poisnoir/Capstone/contract/icd/README.md

# Interface control documents (ICDs)

An ICD freezes one interface: the physical layer, the information that crosses,
the rates/limits, the failsafe behaviour, and what is left to the implementers.
Each ICD names an owner on each side.

| ICD | Interface | Status | Owners |
|---|---|---|---|
| `pico_link.md` | BRD-01 (FPGA) ↔ Pico 2 follower | **Rev A, frozen 2026-10-28** | FPGA engineer / follower firmware |
| `adc_fpga.md` | AD7768-4 ↔ FPGA capture | Stub — see SC-05/SC-05a–c, SC-07 | Tung / William |
| `dac_fpga.md` | DAC80508 ↔ FPGA DDS/SPI | Stub — see decision #19, SC-07 | Tung / Kevin |
| `power.md` | Power entry, E-stop, rails, grounding | Stub — see decision #7/#10/#20 | Tung |
| `mechanical.md` | FG/pen/enclosure/arm mounts, 150 mm rule | Stub — see SC-01c, SC-04b, D2 | Tung / Tristan |

**A stub is not a frozen interface.** Until an ICD is marked frozen, the
`system_contract.md` rows and the decisions log are the contract. Do not build a
new interface against a stub without a written deviation.

The `pico_link/vectors/` folder holds shared conformance vectors once the Pico
side chooses a frame encoding (ICD §5 leaves encoding, field widths and CRC to
the implementers).
