poisnoir/Capstone/docs/extracts/README.md

# Thesis extracts (local-only working set)

- `Jaeger2018_filament-sensor-model_Ch3_extract.txt` — Ch.3 model/solver
- `Jaeger2018_bespoke-sensor_Ch7_extract.txt` — Ch.7 coil design
- `Jaeger2018_filament-sensor-model_extract.pdf` — 27-page crop

All three are **not in the repository** (thesis copyright). Generate them
locally from the full thesis:

```bash
# default: ./HAJ_Thesis_2018.pdf; override with THESIS=/path/to/thesis.pdf
./tools/extract_jaeger.sh
```

The full thesis is not in the repo; see `../reference/MANIFEST.md` REF-01.
