poisnoir/Capstone/docs/handoff/README.md

# Handoff documents

Working handoffs between subsystems. These are design records, not the
contract; if a handoff and `contract/` disagree, the contract wins.

| Document | What it covers |
|---|---|
| `m16-fpga-handoff.md` | M16 DAC/filter decision, FPGA interface, pinout, clocking |
| `solver-algorithm-handoff.md` | LM/TRF solver port, cost function, retry strategy |
| `system-flowchart-handoff.md` | System flow, stage boundaries, schedule |
| `EM-AccuBot-system.svg` | System block diagram |
| `EM-AccuBot-fpga-pipeline.svg` | FPGA pipeline diagram |
| `m16-section-diagram.png` / `.svg` | M16 section diagram |

The Phase 2 design record is in `../phase2/`.
