poisnoir/Capstone/hardware/brd-01/frontend/README.md

# hardware/brd-01/frontend — receiver amp + pen coil (reference)

Upstream (pristine, do not edit): `vendor/anser-osf/Design Files/Sensor Amplifier/`
- `CAD/Sensor Amplifier PCB (Eagle).zip` — `E301 2.0/3.0 .brd/.sch` (Eagle)
- `CAD/Gerbers/Sensor Amplifier PCB Gerbers.rar`

Pen sensor itself: hand-wound per thesis Ch.7 (see `docs/extracts/`, Table 7.1 coils A–E,
ferrite 3C90 12×6mm µr≈2300 for +10dB). New pen mechanics + preamp/ADC interface live here.
