poisnoir/Capstone/docs/reference/anser-osf-provenance.md

# PROVENANCE — vendor/anser-osf (pristine upstream snapshot, do not edit)

- Source: OSF project **Anser EMT** (node `47q8q`), "An open electromagnetic tracking system platform"
- API: `https://api.osf.io/v2/nodes/47q8q/` — downloaded 2026-10-13 via
  `api.osf.io/v2/nodes/47q8q/files/osfstorage/<id>/` listing + `osf.io/download/<guid>/?direct`
- Upstream: `https://osf.io/47q8q/` (project), code pointer in `P&O Code/Matlab/Latest Code.txt`:
  `https://github.com/BioDesignUCC/AnserEMT` (check — siblings: `AlexJaeger/AnserEMT`,
  `AlexJaeger/python-anser`, `StephenHinds/qt-anser`, `AnserEMT/Homepage-Anser`)
- Snapshot: 35 files, ~43MB, `DONE files=35 fails=[]`
- Top level: `Design Files/` (FG board, emitter coil, sensor amp, AC driver),
  `P&O Code/Matlab/` (`MatlabCode.zip` + `Latest Code.txt`), `System Manual/` (`Manual.pdf`, 23pp, 2017)
- License holders (OSF metadata): Alexander Jaeger, Kilian O Donoghue (2017)
- Rule: never edit files here. Port/reference into `software/`, `hardware/`, `docs/`;
  record the mapping in each destination README.
