poisnoir/Capstone/docs/reference/MANIFEST.md

# Reference manifest

These files are **not in the repository** (copyright, size, or both). Each row says what it is, which docs use it, and how to obtain it. `manifest.yml` is the source of truth; this page is generated by `python3 tools/gen_reference_manifest.py`.

`python3 tools/check_references.py` verifies that every external file referenced in a doc has a row here. The repo is public; run the **public-repo checklist** at the bottom before a release.

Manifest version: 1 · updated 2026-10-29

| ID | File | Size | Needed for | How to obtain | Publish? |
|---|---|---|---|---|---|
| REF-01 | `HAJ_Thesis_2018.pdf` | 116 MB | AGENTS.md reference model; contract/system_contract.md SC-01…SC-04; docs/phase2/README.md and the design record | UCC CORA repository / author; a local copy is already on a team machine | no |
| REF-02 | `AnserEMT-onlineversion.pdf` | 2.1 MB | docs/phase2/README.md baseline (1.14 mm / 0.04°); docs/phase2/anser-baseline-findings.md | Publisher / IEEE; cite the paper, do not redistribute | link-only |
| REF-03 | `Catheter Position Tracking System Using Planar Magnetics and Closed Loop Current Control - Kilian ODonoghue et al.pdf` | 1.8 MB | AGENTS.md closed-loop current-driver rule; docs/phase2/pen_link_budget.md | Publisher / IEEE; cite the paper, do not redistribute | link-only |
| REF-04 | `Capstone_Manual_2026.pdf` | 456 KB | docs/phase2/README.md Phase 2 deliverables; docs/phase2/design_order.md | Concordia course Moodle | no |
| REF-05 | `12477_Cavaliere.pdf` | 21 MB | background reading only | Local copy / library; provenance to be confirmed | no |
| REF-06 | `vendor/anser-osf/` | 43 MB | hardware/fg-01/, hardware/brd-01/driver/, hardware/brd-01/frontend/; software/anser-matlab-ref/ (unpacked MATLAB golden model); docs/reference/anser-osf-provenance.md | OSF node 47q8q; download the snapshot, keep it pristine — https://osf.io/47q8q/ | no |
| REF-07 | `docs/ad7768-ad7768-4.pdf` | 4.0 MB | contract/system_contract.md SC-05; docs/phase2/adc_justification.md; docs/phase2/adc_interface_closure.md | Analog Devices product page (AD7768-4), datasheet Rev.D — https://www.analog.com/en/products/ad7768-4.html | link-only |
| REF-08 | `reference-cache/datasheets/` | 16 MB | hardware/brd-01/ part selection and layout; docs/phase2/driver_power_requirements.md | Each manufacturer by part number: AD7768-4, ADS1274, DAC80508, LTC1563-2, LMH6321, INA163, ADA4940-2, ADR434, ME60A1503F01, RV-1515D, TPS7A4701/TPS7A33/TPS7A20, XC7A35T/XC7A50T, Citizen CSX750FBC32.768M; Neutrik/Mogami connectors and cable | no |
| REF-09 | `docs/extracts/Jaeger2018_filament-sensor-model_extract.pdf` | 4.2 MB | agent working set; Ch.3 model/solver and Ch.7 coil design | Generated from REF-01; do not redistribute the crop | no |
| REF-10 | `docs/Materials procurement.pdf` | 1.2 MB | procurement/BOM practice reference | Concordia course Moodle | no |
| REF-11 | `docs/phase1/Phase 1 Report - Team 25 (ELEC-COEN 490).docx` | 228 KB | Phase 1 specs #1–25 and the frozen baseline; docs/phase2/README.md | Team file; local-only, not in the repo (contains student IDs) | no |
| REF-12 | `docs/extracts/Jaeger2018_filament-sensor-model_Ch3_extract.txt` | 22 KB | AGENTS.md reference model; fpga/ solver port | Generated from REF-01; local-only, not in the repo (thesis copyright) | no |
| REF-13 | `docs/extracts/Jaeger2018_bespoke-sensor_Ch7_extract.txt` | 33 KB | AGENTS.md coil design (Table 7.1); hardware/pen/ | Generated from REF-01; local-only, not in the repo (thesis copyright) | no |

## Acquisition details

### REF-01 — Jaeger, electromagnetic tracking thesis (UCC, 2018), 282 pp

- **File:** `HAJ_Thesis_2018.pdf`
- **Size:** 116 MB
- **Needed for:** AGENTS.md reference model; contract/system_contract.md SC-01…SC-04; docs/phase2/README.md and the design record
- **How to obtain:** UCC CORA repository / author; a local copy is already on a team machine
- **Local path:** `<local>/CAPSTONE/HAJ_Thesis_2018.pdf`
- **Publish:** False
- **SHA-256:** `eebd2824176a1af256fd1e3361289dd8a110bd29eb318e36d1d4a2b843809e8e`
- **Regenerate:** docs/extracts/*.txt and the PDF crop via tools/extract_jaeger.sh

### REF-02 — Jaeger et al., Anser EMT (IEEE TBME, 2017)

- **File:** `AnserEMT-onlineversion.pdf`
- **Size:** 2.1 MB
- **Needed for:** docs/phase2/README.md baseline (1.14 mm / 0.04°); docs/phase2/anser-baseline-findings.md
- **How to obtain:** Publisher / IEEE; cite the paper, do not redistribute
- **Local path:** `<local>/CAPSTONE/AnserEMT-onlineversion.pdf`
- **Publish:** link-only
- **SHA-256:** `2fa9926ae2758b5af40cd16a801190821a01eb35834f7e8dced8747d6a1dc520`

### REF-03 — O'Donoghue et al., catheter tracking with planar magnetics (2014)

- **File:** `Catheter Position Tracking System Using Planar Magnetics and Closed Loop Current Control - Kilian ODonoghue et al.pdf`
- **Size:** 1.8 MB
- **Needed for:** AGENTS.md closed-loop current-driver rule; docs/phase2/pen_link_budget.md
- **How to obtain:** Publisher / IEEE; cite the paper, do not redistribute
- **Local path:** `<local>/CAPSTONE/Catheter Position Tracking System Using Planar Magnetics and Closed Loop Current Control - Kilian ODonoghue et al.pdf`
- **Publish:** link-only
- **SHA-256:** `b05e3d82fdae04b52dcc2541691f10af3c3b059ac2838022524bbab8bc087af9`

### REF-04 — Concordia ELEC/COEN 490 Capstone manual 2026

- **File:** `Capstone_Manual_2026.pdf`
- **Size:** 456 KB
- **Needed for:** docs/phase2/README.md Phase 2 deliverables; docs/phase2/design_order.md
- **How to obtain:** Concordia course Moodle
- **Local path:** `<local>/CAPSTONE/Capstone_Manual_2026.pdf`
- **Publish:** False
- **SHA-256:** `2ba7b441a31877a31d0e0416103b7bb66e8ac4697107b7dc5aa56b17397c06c4`

### REF-05 — Cavaliere reference document (local copy)

- **File:** `12477_Cavaliere.pdf`
- **Size:** 21 MB
- **Needed for:** background reading only
- **How to obtain:** Local copy / library; provenance to be confirmed
- **Local path:** `<local>/CAPSTONE/12477_Cavaliere.pdf`
- **Publish:** False
- **SHA-256:** `d337f4ebb04611408f6ec238b79f92c7a3a17e8bb0f1ea0ec5198b81c8ab988c`

### REF-06 — Anser OSF snapshot (node 47q8q, 35 files, 2026-10-13)

- **File:** `vendor/anser-osf/`
- **Size:** 43 MB
- **Needed for:** hardware/fg-01/, hardware/brd-01/driver/, hardware/brd-01/frontend/; software/anser-matlab-ref/ (unpacked MATLAB golden model); docs/reference/anser-osf-provenance.md
- **How to obtain:** OSF node 47q8q; download the snapshot, keep it pristine
- **URL:** https://osf.io/47q8q/
- **Local path:** `<local>/CAPSTONE/vendor/anser-osf/`
- **Publish:** False
- **SHA-256:** `3b4446554229825f57d2f7e8fcf72e74ba61e0ca850b7e627f75c092b071d9ad`
- **Regenerate:** see docs/reference/anser-osf-provenance.md

### REF-07 — Analog Devices AD7768 / AD7768-4 datasheet Rev.D

- **File:** `docs/ad7768-ad7768-4.pdf`
- **Size:** 4.0 MB
- **Needed for:** contract/system_contract.md SC-05; docs/phase2/adc_justification.md; docs/phase2/adc_interface_closure.md
- **How to obtain:** Analog Devices product page (AD7768-4), datasheet Rev.D
- **URL:** https://www.analog.com/en/products/ad7768-4.html
- **Local path:** `<local>/CAPSTONE/docs/ad7768-ad7768-4.pdf`
- **Publish:** link-only
- **SHA-256:** `bbb52b34c5a251b9dc01719357f3f80a1d4c2b274f2136704c80500cdd7d3e27`

### REF-08 — Manufacturer datasheets (ADC, DAC, driver, connectors, cable)

- **File:** `reference-cache/datasheets/`
- **Size:** 16 MB
- **Needed for:** hardware/brd-01/ part selection and layout; docs/phase2/driver_power_requirements.md
- **How to obtain:** Each manufacturer by part number: AD7768-4, ADS1274, DAC80508, LTC1563-2, LMH6321, INA163, ADA4940-2, ADR434, ME60A1503F01, RV-1515D, TPS7A4701/TPS7A33/TPS7A20, XC7A35T/XC7A50T, Citizen CSX750FBC32.768M; Neutrik/Mogami connectors and cable
- **Local path:** `<local>/CAPSTONE/reference-cache/datasheets/`
- **Publish:** False
- **SHA-256:** `08782fd1accd4bfe586a5f1e83a547d940913ad303f28500998afbc5d8fd60a4`
- **Regenerate:** download from each vendor; keep the filename

### REF-09 — Jaeger thesis extract, PDF pp.84–94 + 199–214 (27 pp)

- **File:** `docs/extracts/Jaeger2018_filament-sensor-model_extract.pdf`
- **Size:** 4.2 MB
- **Needed for:** agent working set; Ch.3 model/solver and Ch.7 coil design
- **How to obtain:** Generated from REF-01; do not redistribute the crop
- **Local path:** `<local>/CAPSTONE/docs/extracts/Jaeger2018_filament-sensor-model_extract.pdf`
- **Publish:** False
- **SHA-256:** `547966dbd079fe2e303aecc25bc1da23aa163418bebcd1f899888321a433d0c1`
- **Regenerate:** tools/extract_jaeger.sh (needs REF-01)

### REF-10 — COEN/ELEC 390 materials-procurement lecture (course material)

- **File:** `docs/Materials procurement.pdf`
- **Size:** 1.2 MB
- **Needed for:** procurement/BOM practice reference
- **How to obtain:** Concordia course Moodle
- **Local path:** `<local>/CAPSTONE/docs/Materials procurement.pdf`
- **Publish:** False
- **SHA-256:** `d3b91997360d8b05a39356cbaf6ce3da1eee69a4009f7a31863e243db2628726`

### REF-11 — Team 25 Phase 1 report (contains student IDs)

- **File:** `docs/phase1/Phase 1 Report - Team 25 (ELEC-COEN 490).docx`
- **Size:** 228 KB
- **Needed for:** Phase 1 specs #1–25 and the frozen baseline; docs/phase2/README.md
- **How to obtain:** Team file; local-only, not in the repo (contains student IDs)
- **Local path:** `<local>/CAPSTONE/docs/phase1/Phase 1 Report - Team 25 (ELEC-COEN 490).docx`
- **Publish:** False
- **SHA-256:** `24367e96278e5915f5d284fd3ab2a7793fe1be6be71fdba9ea64e68475d7142e`

### REF-12 — Jaeger Ch.3 text extract (local-only)

- **File:** `docs/extracts/Jaeger2018_filament-sensor-model_Ch3_extract.txt`
- **Size:** 22 KB
- **Needed for:** AGENTS.md reference model; fpga/ solver port
- **How to obtain:** Generated from REF-01; local-only, not in the repo (thesis copyright)
- **Local path:** `<local>/CAPSTONE/docs/extracts/Jaeger2018_filament-sensor-model_Ch3_extract.txt`
- **Publish:** False
- **SHA-256:** `generated; see tools/extract_jaeger.sh`
- **Regenerate:** tools/extract_jaeger.sh (needs REF-01)

### REF-13 — Jaeger Ch.7 text extract (local-only)

- **File:** `docs/extracts/Jaeger2018_bespoke-sensor_Ch7_extract.txt`
- **Size:** 33 KB
- **Needed for:** AGENTS.md coil design (Table 7.1); hardware/pen/
- **How to obtain:** Generated from REF-01; local-only, not in the repo (thesis copyright)
- **Local path:** `<local>/CAPSTONE/docs/extracts/Jaeger2018_bespoke-sensor_Ch7_extract.txt`
- **Publish:** False
- **SHA-256:** `generated; see tools/extract_jaeger.sh`
- **Regenerate:** tools/extract_jaeger.sh (needs REF-01)

## Regenerating the thesis extracts

The `.txt` extracts and the 27-page PDF crop are local-only (not tracked). Both are generated from REF-01:

```bash
# default: ./HAJ_Thesis_2018.pdf; override with THESIS=/path/to/thesis.pdf
./tools/extract_jaeger.sh
```

## Public-repo checklist

- [ ] Confirm the Phase 1 report is not tracked: `git ls-files | grep -i 'Phase 1 Report'` is empty.
- [ ] Confirm the thesis `.txt` extracts are not tracked.
- [ ] Confirm no tracked PDFs: `git ls-files | grep -i '\.pdf$'` is empty.
- [ ] Run `python3 tools/check_publish.py --public`.
- [ ] Run `python3 tools/check_references.py` and `python3 tools/check_doc_paths.py`.
- [ ] Flip visibility, then enable the branch ruleset (PR, 1 approval, code owners, status checks).
