poisnoir/Capstone/docs/phase1/README.md

# Phase 1 report (local-only)

`Phase 1 Report - Team 25 (ELEC-COEN 490).docx` — the frozen Phase 1 baseline
(specs #1–25, success criteria, schedule, budget).

**This file is not in the repository** because it contains student IDs. Ask a
team member for a copy (team drive / local machine). `tools/check_publish.py
--public` fails if it is ever tracked.

The Phase 2 design record is in `../phase2/`; the shared contract is in
`../../contract/`.
