poisnoir/Capstone/docs/reference/README.md

# Reference manifest

Third-party PDFs, datasheets and the vendor snapshot are **not committed**.
`manifest.yml` is the source of truth; `MANIFEST.md` is generated from it.

- `manifest.yml` — one entry per external file: ID, size, which docs use it, how
  to obtain it, publish permission, SHA-256, regeneration command.
- `MANIFEST.md` — the human-readable table and acquisition details. Generated by
  `python3 tools/gen_reference_manifest.py`.
- `anser-osf-provenance.md` — the tracked provenance summary for the OSF
  snapshot (`vendor/` is local-only).

## Add a reference

1. Add an entry to `manifest.yml` with an acquisition method (URL/DOI/OSF node/
   course Moodle/author) and a local path.
2. Run `python3 tools/gen_reference_manifest.py`.
3. Run `python3 tools/check_references.py`.

If a doc references a third-party file without a manifest row, the checker
fails. That is intentional: a reference nobody can obtain is not a reference.

## Current local-only locations

| Path | What |
|---|---|
| `vendor/anser-osf/` | OSF node `47q8q` snapshot (43 MB) |
| `reference-cache/datasheets/` | manufacturer datasheets (16 MB) |
| root `HAJ_Thesis_2018.pdf` | Jaeger thesis (116 MB) |
| root `AnserEMT-onlineversion.pdf`, `Catheter...pdf` | papers |
| root `Capstone_Manual_2026.pdf`, `12477_Cavaliere.pdf` | course/reference |
| `docs/ad7768-ad7768-4.pdf` | ADI datasheet |
| `docs/extracts/*.pdf` | thesis crop (regenerate with `tools/extract_jaeger.sh`) |
| `docs/extracts/*.txt` | thesis text extracts (local-only, copyright) |
| `docs/phase1/Phase 1 Report - Team 25 (ELEC-COEN 490).docx` | Phase 1 report (student IDs; local-only) |
| `docs/Materials procurement.pdf` | course lecture |
| `simulations/**/*.raw` | LTspice output (regenerate from `.cir`) |

The `.txt` thesis extracts and the Phase 1 report are **not tracked**. They are
kept on team machines only; `python3 tools/check_publish.py --public` fails if
either is ever added to git.
