poisnoir/Capstone/hardware/bom/BOM_ADC-01.xlsx

Sheet: README_AGENTS
BOM WORKING RULES — ADC-01 (Team 25, EM AccuBot). Shared format/process rules: see BOM_PEN-ANA-01.xlsx > README_AGENTS (same lecture: docs/Materials procurement.pdf + docs/BOM_template.xls). This file = sub-assembly ADC-01 ONLY (signal-path ADC + Vref). RQ: phase2/adc_justification.md RQ-A1..A7 + §9c-§9e.
LOCKED: AD7768-4 (RL7 if qty-1 price confirms, else RL) primary per §9e gate (simultaneous 4-ch, 256kSPS, D=133µs, lanes OK, DigiKey stock). BACKUP (QTY=0, do not order): ADS1274IPAPR (144kSPS, N≤500 frames). Vref ADR434BRZ 4.096V (CN-0540-class pairing).
OPEN ITEMS before order: (1) re-quote RL7 vs RL qty-1 in cart; (2) ADI lifecycle check (Mouser delist note); (3) ADC input network (precharge buffer/RC) settled — datasheet now in docs/; the 73pF coil budget is cable+conn+preamp input, not ADC Cin (see tone_plan.md); (4) MCLK coherency/jitter from TCXO/PLL plan (tone_plan integer-J; 1ns=73.4dB at 34kHz); (5) decoupling values at schematic (not listed here). Sign header before issue.

Sheet: BOM_ADC-01
Company: | Concordia University, Department of Electrical and Computer Engineering
Project: | EM AccuBot — Team 25 (ELEC/COEN 490)
Design ref.: | ADC-01 — Signal-path ADC + Vref (4-ch simultaneous SD + 4.096V ref)
Prepared by: | _Your name_ (replace placeholder before issue)
Rev.# | 0.01 | Date: | 2026-10-16 | (YYYY-MM-DD)
Approved by: | (sign before order)
Item # | Design Reference # | Description | Value | QTY | Unit | Manufacturer | Manufacturer Part# | Package | Type | Supplier | Supplier P/N | Price (CAD) | Ext.price (CAD)
1 | U1 | 24-bit 4-ch simultaneous sigma-delta ADC, 256kSPS/ch, FIR D=34/ODR≈133µs, SPI lanes (DCLK≥8.2M), 108dB DR; signal path Ch0=current pseudo-diff, Ch1=pen, Ch2=ref (LOCKED §9e) | AD7768-4BSTZ-RL7 (RL if cheaper @qty1) | 2 | pcs | Analog Devices | AD7768-4BSTZ-RL7 | 64-LQFP | IC-ADC | Digi-Key | AD7768-4BSTZ-RL7-ND? verify RL7-vs-RL qty-1 price in cart | 49.65
2 | U1-ALT (DO NOT ORDER) | 24-bit 4-ch simultaneous SD ADC, to 144kSPS; BACKUP ONLY (N≤500 frames; HTQFP PowerPAD needs hot-air/JLC) | ADS1274IPAPR | 0 | pcs | Texas Instruments | ADS1274IPAPR | HTQFP-64 PowerPAD | IC-ADC | Digi-Key | verify -ND at promotion time | TBD (backup)
3 | U2 | Series Vref 4.096V XFET 0.04% (CN-0540-class pairing for AD7768 REF); ADR4540 lower-noise alt documented not ordered | ADR434BRZ | 1 | pcs | Analog Devices | ADR434BRZ | 8-SOIC | IC-VREF | Digi-Key | ADR434BRZ-ND? verify in cart | 23.01
TOTAL this sub-assembly (CAD) — Rev 0.01 (re-quote RL7/RL + verify P/Ns at order)
NOTES: MCLK from TCXO/PLL (no part; FPGA clock plan). Cin + droop-temp + lifecycle checks per §9e before order. Decoupling values at schematic Rev (not listed).

Sheet: Sourcing_notes
Purpose | Pointers + order-time facts for ADC-01. RQ lives in phase2/adc_justification.md (RQ-A1..A7, §9c-§9e); do not duplicate math here.
U1 trace | §9e gate: simultaneous ✓ (4-ch), 256k≥250k preferred ✓ (at the line), D=133µs<0.5ms ✓, BW 110.8k ✓, 108dB ✓, lanes ✓. Chan map: Ch0 driver-current pseudo-diff, Ch1 pen true-diff, Ch2 ref, Ch3 spare. N=500→1.95ms / N=1000→3.9ms acq.
U1 order facts | DigiKey RL p.6056981 qty1 $34.84 USD=$49.65 CAD (x1.425), stock 4 (thin). RL7 p.6056982 also in-stock — compare qty-1 unit price in cart, take cheaper; fallback RL. Mouser 925 but delist-on-depletion note → run ADI lifecycle check pre-order.
U1-ALT facts | ADS1274IPAPR: TI quad 24b SD to 144kSPS, ~5.8k stock, CT available. Clears 110k floor thin, below 250k preferred → backup only, N≤500. PowerPAD → hot-air/JLC. Promote only if AD7768 fails Cin/lifecycle/droop checks.
U2 facts | ADR434BRZ DigiKey p.997797 in-stock $16.15 USD=$23.01 CAD. CN-0540 used ADR4540 (lower noise) — alt documented, not ordered. QTY 1: Newsboy p*=23.01/31.01=74% vs SOIC kill-risk ~10% → no spare.
Newsboy U1 | p*=49.65/(8+49.65)=86% vs student-kills-64-LQFP risk ~30% → math says 1; ordering 2 anyway (build + 1 spare) on stock-risk grounds (4 left at DigiKey). Recorded as risk-driven override. JLCPCB assembly considered to cut solder risk.
Budget trace | ADC-01 Rev 0.01: 2×49.65+23.01=$122.31 CAD (+~$8 shared DigiKey ship if batched with PEN-ANA-01 conn order). System-to-date ≈ $67.96+$122.31=$190.27 vs ≤1000 CAD/pair (#24).
Do-not-do | No FG/PMS/enclosure rows here. No TBD at order (U1 RL7/RL price + suffixes verified in cart). No edits to docs/BOM_template.xls or vendor/.
