poisnoir/Capstone/hardware/bom/BOM_PEN-ANA-01.xlsx

Sheet: README_AGENTS
BOM WORKING RULES — READ BEFORE PROCURING (Team 25, EM AccuBot)
Source of truth for FORMAT: docs/BOM_template.xls + lecture docs/Materials procurement.pdf (Dmitry, COEN/ELEC 390). Source of truth for CONTENT here: phase2/connector_requirements.xlsx (Locked-CONN / Locked-CAB sheets) + phase2/README.md specs #1-25 + AGENTS.md. This workbook is the orderable BOM for ONE sub-assembly only (PEN-ANA-01). Requirements history and ALT matrices stay in connector_requirements.xlsx — do not duplicate them here; reference them.
PRINCIPLES DISTILLED FROM THE LECTURE + TEMPLATE
SEARCH (before a part enters the BOM):
1. Define WHAT first: type/application + key parameters (voltage/current, size/footprint, temp range, power, mating cycles, capacitance, mass). Never search by price first. (Lecture pp.28-31; RQ sheets in connector_requirements.xlsx are this step written down.)
2. Every candidate must pass the subsystem RQ thresholds with MATH, not vibes (e.g. RQ-C2 contact-R, RQ-C3 C_total<=73pF / fres>10x34kHz, RQ-B2 cable K0 budget, ADC RQ-A1..A7). Record the calculation in connector_requirements.xlsx or phase2/*.md, then list only the winner here.
3. Newsboy spares rule (lecture pp.3-9): break-even 0 = shipping*p - part*(1-p) -> p = part/(shipping+part); with salvage value 0 = shipping*p - (part-salvage)*(1-p). If P(need spare) > p, order the spare NOW (a second DigiKey shipment costs more than the part). Worked example: $8 shipping, $3 ATmega -> p=27%; 30% burn risk -> order 2nd chip. Apply to every BOM line before submitting the order; document the spare count.
4. Approved suppliers: Montreal walk-in Abra / Addison; Canada DigiKey.ca / Mouser.ca / Newark (canada.newark.com); bulk cable Studio Economik (walk-in, per-foot IDs in Sourcing_notes). Prefer a single supplier per order to amortize shipping (Newsboy).
5. Packaging for prototypes: Cut Tape (CT) / cut-length cable — NOT full Tape&Reel / Digi-Reel. Order exact qty + Newsboy spares.
FORMATTING (this sheet must always match docs/BOM_template.xls):
6. Header block rows 1-6: Company / Project / Design ref. / Prepared by / Rev.# + Date / Approved by. Never ship a BOM with _placeholders_ still in it.
7. Columns, in order, no renames: Item # | Design Reference # | Description | Value | QTY | Unit | Manufacturer | Manufacturer Part# | Package | Type | Supplier | Supplier P/N | Price (CAD) | Ext.price (CAD). Unit = units of QTY (pcs/ft/m), never value units.
8. One row per unique Manufacturer Part#. Group designators (e.g. J1,J2 — never one row per instance). Item # consecutive 1.0, 2.0, ....
9. Description = key parameters summary; Value = nominal (R/C/L) or MPN for everything else. No physical dimensions as line items (BOM definition, lecture p.11) — dimensions live in schematics/drawings.
10. All money in CAD, Price = unit''''s quote at order qty, Ext.price = QTY*Price (formula, 2 decimals), bottom row = GRAND TOTAL. FX if needed: 1 USD=1.425 / 1 EUR=1.604 CAD (Oct 2026, phase2/README.md). Landscape fit-to-page on print.
11. One BOM per assembly level (lecture pp.20-21): this file = sub-assembly PEN-ANA-01 ONLY (pen analog link). Do not append FG coils, ADC, PMS stage, or enclosure rows here — open BOM_<SUB>-<NN>.xlsx for those.
12. Alternates/second-sources are DOCUMENTED, not ordered: keep them in connector_requirements.xlsx ALT sheets + Sourcing_notes here; only the LOCKED winner gets a BOM row. Exception: explicitly mark ALT rows QTY=0 + 'DO NOT ORDER'.
WORKFLOW FOR FUTURE AGENTS:
A. Pick part against RQ (update RQ/ALT sheets in connector_requirements.xlsx with numbers, OIQ 3.1.2 weighted matrix style).
B. Add/extend ONE row here in template columns; QTY includes Newsboy spares (note spare math in Sourcing_notes).
C. Fill Supplier + Supplier P/N from the actual cart (exact string, e.g. DigiKey 22517901-ND style); re-quote Price at the real order qty; confirm Ext.price formula + TOTAL.
D. Replace header placeholders (Prepared by / Rev / Date / Approved by); bump Rev.# on every change; never edit docs/BOM_template.xls or vendor/.
E. Cross-checks before submit: sum(QTY per Design Ref) ok; Unit sane; every row has MPN + Supplier P/N (no TBD at order time); TOTAL <= budget slice (<=1000 CAD/pair system, Phase 1 #24); metal/mass/field constraints unaffected (#19 PEN<=50g, #20 <=27uT, 150mm metal-free).
STATUS OF THIS FILE (Rev 0.01, 2026-10-16): connector + cable LOCKED rows ported from connector_requirements.xlsx Rev B/C. Connector unit prices = TBD (re-quote at order; ALT-matrix estimates ~$3-4/ea IO, ~$9-13/ea Amphenol — do NOT treat as quotes). Cable prices from Economik per-foot walk-in. Spare-pair Newsboy calc NOT yet applied to L1/L2 (flagged in Sourcing_notes).

Sheet: BOM_PEN-ANA-01
Company: | Concordia University, Department of Electrical and Computer Engineering
Project: | EM AccuBot — Team 25 (ELEC/COEN 490)
Design ref.: | PEN-ANA-01 — Pen analog link (sensor coil -> preamp), 2 channels
Prepared by: | _Your name_ (replace placeholder before issue)
Rev.# | 0.03 (tone plan 34 kHz: Ctotal<=73pF; W2697 still compliant; ALT-cable worst-case claim withdrawn) | Date: | 2026-10-26 | (YYYY-MM-DD)
Approved by: | (sign before order)
Item # | Design Reference # | Description | Value | QTY | Unit | Manufacturer | Manufacturer Part# | Package | Type | Supplier | Supplier P/N | Price (CAD) | Ext.price (CAD)
1.0 | J1, J2 | Mini-XLR 3-pos chassis receptacle, MALE pins, solder cup, brass/gold, <=10mΩ, >1GΩ, 1000V/60s, >1000 cycles, IEC 61076-2-103 (panel bulkhead, preamp box) | IO-TXLR3-M-PS-1 | 3 | pcs | IO | IO-TXLR3-M-PS-1 | mini-XLR-3 panel | connector | Digi-Key | 1937-IO-TXLR3-M-PS-1-ND (verify …-ND suffix at order) | $8.41
2.0 | P1, P2 | Mini-XLR 3-pos cable plug, FEMALE sockets, solder, bronze/gold, <=10mΩ, 5A/50V, for 2-3.5mm OD cable, mates J1/J2 same-brand pairs (pen whip end) | IO-TXLR3-F | 3 | pcs | IO | IO-TXLR3-F | mini-XLR-3 cable | connector | Digi-Key (same order as Item 1) | 1937-IO-TXLR3-F-ND (verify …-ND suffix at order) | $9.06
3.0 | W1a, W1b (+spare cut) | Balanced mic cable 2c 28AWG stranded + served shield, 2.5mm OD, ~65pF/m; 0.6m/whip => ~59pF total w/ conn+amp <=73pF budget at 34kHz; pen whip, lavalier flex (LOCKED Rev C) | W2697 | 10 | ft | Mogami | W2697 | bulk cut | cable-bulk | Studio Economik (walk-in) | ID 12608 | $0.75
4.0 | W2 (static ref run) | Mini quad cable 4c 26AWG paralleled-to-pair + shield, ~4mm OD, ~130pF/m; STATIC REFERENCE ONLY (jacket-strip to fit chuck); max 0.5m on air coils (LOCKED Rev C) | W2893 | 5 | ft | Mogami | W2893 | bulk cut | cable-bulk | Studio Economik (walk-in) | ID 5521 | $1.61
TOTAL this sub-assembly (CAD) — Rev 0.02 (verify …-ND suffix + re-quote at order; sign header before issue)
NOTES (not orderable rows — process, not parts): C3 termination per AES48: pen plug Pin1 = braid ONLY, coil-to-shield = open (DMM ∞Ω); panel Pin1+shell -> chassis star; pigtail <10mm. Female cable -> male panel (mic convention, no exposed live pins on pen). Current-sense stays BNC, NOT in this BOM. Second source (documented, not ordered): Amphenol AG3MCC + AG3F. See connector_requirements.xlsx ALT-matrix + Sourcing_notes sheet.

Sheet: Sourcing_notes
Purpose | Trace every BOM row back to its locked decision + RQ so a future agent can re-quote or re-vet without re-researching. Requirements live in phase2/connector_requirements.xlsx; this sheet is pointers + order-time facts.
L1/L2 trace | Locked-CONN Rev B: IO primary, Amphenol AG3MCC+AG3F approved second-source. RQ-C1..C6 (3-pole, Rc<=30mΩ/ΔR<=10mΩ, Cc<=10pF/Ctot<=73pF, >1000 mates, 360° shield star-at-ADC, Pmod-digital-not-here). Preamp-box panel mount; female-on-cable convention.
L1 order fact | DigiKey.ca: 1937-IO-TXLR3-M-PS-1-ND @ $5.90 USD = $8.41 CAD (x1.425); IO-TXLR3-F: 1937-IO-TXLR3-F-ND @ $6.36 USD = $9.06 CAD. Prices scraped 2026-10-16 from digikey.com snippets (page 403s bot); VERIFY suffix + re-quote at order qty in cart.
L2 order fact | CONSOLIDATED to Digi-Key same order as L1 (single-supplier rule, amortizes 1x shipping). Same-brand-per-pair preserved (both IO). Exact P/N above; verify at order; do not submit with TBD.
C1/C2 trace | Locked-CAB Rev C: W2697 pen whip (2.5mm fits IO chuck 2-3.5mm, 0.6m≈59pF passes worst-case 3mH/73pF); W2893 static-ref only (~4mm, jacket-strip trick, ≤0.5m on air coils). RQ-B1..B5 (AWG/R, K0/K1 capacitance, braid-not-foil, OD/mass/flex, twist+star).
Cable order facts | Studio Economik walk-in, per-foot: W2697 ID 12608 $0.75 CAD/ft; W2893 ID 5521 $1.61 CAD/ft (prices as filed; re-confirm at counter). Qty unit = ft to match the price list. 10 ft = 2×0.6m whips + spare/rework; 5 ft = static-ref run + spare.
Newsboy flag | Newsboy 2026-10-16 (shipping $8 lecture fig., DigiKey.ca small-order): M-PS-1 p*=8.41/(8+8.41)=51%; F p*=9.06/(8+9.06)=53%. P(>=1 rework/damage over 4 hand-soldered Tiny-XLR, ~20%/ea)=1-0.8^4=59% > p* -> +1 spare ea. (qty 2->3). Cable walk-in ship=$0 -> p*=100%, no ship-driven spares; 10ft already holds 6ft rework spare (2x0.6m used).
Budget trace | Rev 0.02 slice TOTAL: conn 3x8.41+3x9.06=$52.41 + cable 10x0.75+5x1.61=$15.55 = $67.96 CAD parts (+~$8 ship). Phase 1 #24: <=1000 CAD/pair system. Placeholders left: Prepared by / Approved by (sign before order).
Do-not-do | Do not add FG/ADC/PMS/enclosure rows here (BOM levels, lecture pp.20-21). Do not put dimensions in BOM. Do not order with TBD/placeholder cells. Do not edit docs/BOM_template.xls or vendor/.
