poisnoir/Capstone/hardware/bom/BOM_SYSTEM-01.xlsx

Sheet: README_AGENTS
BOM WORKING RULES - SYSTEM-01 (EM AccuBot, Team 25)
Purpose: full-system BOM Rev 0.02 for the Phase 2 design review. One sheet per assembly level; the Roll_up sheet totals them. M16 DAC/filter selected 2026-10-27.
Format: docs/BOM_template.xls + docs/Materials procurement.pdf (Dmitry, COEN/ELEC 390).
Money: CAD. FX 1 USD = 1.425 CAD, 1 EUR = 1.604 CAD (Oct 2026).
Price is an estimate at the order quantity; re-quote before purchase. No row may ship with a placeholder supplier P/N.
Newsboy spares: build + spare quantities are used for AD7768-4, AD5541A, LMH6321, INA163, ADA4940-2, CSX750FBC32.768M. Alternate rows are QTY=0 and DO NOT ORDER.
SHEETS
Roll_up - assembly totals + budget check
FG-01 - 8-coil PCB + connectors + ICNIRP guard
PWR-DRV-01 - 8x AD5541A + 8x LMH6321 + current sense + power + E-stop
FE-ADC-01 - INA163 + ADA4940-2 + AD7768-4 + reference + clock
FPGA-IF-01 - 2x20 interface + opto + fan (FPGA board owned)
PEN-01 - coil B + mini-XLR + cable + reference coil
PMS-01 - MicroManipulatorStepper XYZ + Pico 2 + drivers
ENCL-01 - enclosure + E-stop + camera/display + panel
Sourcing_notes - part trace, lifecycle, budget variance, cost-reduction options
STATUS: Rev 0.04, 2026-10-28. BRD-01 single board; FPGA = PS-less Artix-7 XC7A35T-1FTG256C (no DDR3/PS); M16 DAC80508 + 8x LTC1563-2. Baseline ~$2349; controller-only ~$1522; trimmed ~$1163; still above the $1000 cap.
The baseline estimate is ABOVE the Phase 1 <=1000 CAD/pair cap. See Sourcing_notes and Roll_up for the variance and the cost-reduction options. Do not order until the team signs the deviation or the trimmed configuration.

Sheet: Roll_up
Company: | Concordia University, Department of Electrical and Computer Engineering
Project: | EM AccuBot - Team 25 (ELEC/COEN 490)
Design ref.: | SYSTEM-01 - full system roll-up
Prepared by: | Team 25 / design review
Rev.# | 0.01 | Date: | 2026-10-27
Approved by: | (sign before order)
SYSTEM ROLL-UP (Rev A, CAD)
Item # | Design Reference # | Description | Value | QTY | Unit | Manufacturer | Manufacturer Part# | Package | Type | Supplier | Supplier P/N | Price (CAD) | Ext.price (CAD)
1 | FG-01 | Field generator PCB + connectors + guard |  | 1 | lot |  |  |  | assembly |  |  | 278.00
2 | BRD-01-A | BRD-01 zone A (one board): 8-ch DAC80508 + 8x LTC1563-2 + 8 current loops + current sense + power + E-stop |  | 1 | lot |  |  |  | assembly
3 | BRD-01-B | BRD-01 zone B (same board): receiver front end + ADC + reference + clock |  | 1 | lot |  |  |  | assembly |  |  | 295.05
4 | BRD-01-C | BRD-01 zone C (same board): FPGA + config flash + USB-UART + opto + watchdog + fan |  | 1 | lot |  |  |  | assembly |  |  | 116.00
5 | PEN-01 | Pen coil B + cable + connectors + reference |  | 1 | lot |  |  |  | assembly |  |  | 152.96
6 | PMS-01 | Follower XYZ stage + Pico 2 + drivers |  | 1 | lot |  |  |  | assembly |  |  | 412.00
7 | ENCL-01 | Enclosure + E-stop + camera/display + panel |  | 1 | lot |  |  |  | assembly |  |  | 415.00
8 | FPGA | FPGA board (owned, Zynq-7020 class) |  | 1 | lot |  |  |  | assembly |  |  | 0.00
 | GRAND TOTAL

Sheet: Budget
BUDGET CHECK - Phase 1 #24 (<=1000 CAD per controller+follower pair)
Baseline Rev A estimate (Roll_up)
Phase 1 cap | 1000
Variance (estimate - cap)
Variance ratio
COST-REDUCTION OPTIONS (not in baseline)
DAC80508 + LTC1563-2 is now the baseline (no incremental saving) | 0
Use 8 build qty, no DAC/LMH/INA/ADA spares | -150
One AD7768-4 (no spare) | -49.65
One FG PCB (no spare) | -95
Use lab camera/monitor instead of buying | -135
Cheaper enclosure (no custom 400x300x150) | -60
Cheaper PMS kit / reuse lab stage | -160
Reduce passives estimate | -65
Trimmed estimate (all options)
Still above cap?
NOTES
M16 baseline selected 2026-10-27: DAC80508 + 8x LTC1563-2. The baseline already includes the M16 DAC/filter; the old AD5541A option is gone.
The follower XYZ stage is a demo test-bed, not the product, but Phase 1 #24 counts the controller+follower pair. Confirm the budget interpretation with the team.
FPGA is on BRD-01 (XC7A35T-1FTG256C, ~$70 CAD). The old owned-dev-board assumption is gone; no Zynq/DDR3 board is bought.
Spares: Newsboy rule. AD5541A p* = 21.14/(8+21.14) = 72%; if burn risk <72%, no spare. The baseline buys 10 for 8 channels.
Controller-only check (exclude PMS-01 and ENCL-01)
Controller-only trimmed (M16 baseline; no spares + 1 ADC + 1 FG PCB + passives)

Sheet: FG-01
Company: | Concordia University, Department of Electrical and Computer Engineering
Project: | EM AccuBot - Team 25 (ELEC/COEN 490)
Design ref.: | FG-01 - 8-coil field generator
Prepared by: | Team 25 / design review
Rev.# | 0.01 | Date: | 2026-10-27
Approved by: | (sign before order)
BOM - FG-01 - 8-coil field generator (Rev A, estimates; re-quote at order)
Item # | Design Reference # | Description | Value | QTY | Unit | Manufacturer | Manufacturer Part# | Package | Type | Supplier | Supplier P/N | Price (CAD) | Ext.price (CAD)
1 | PCB | 8-coil field generator PCB, 300x300 mm, 2-layer, 1.6 mm, 1 oz, ENIG, 25 turns, 0.5/0.25 mm | 300x300 mm | 2 | pcs | JLCPCB | FG-8COIL-300X300-2L | PCB | PCB-fab | JLCPCB | quote at order | 95.00
2 | J1-J8 | 2-pin 3 A keyed board connector, 4.2 mm pitch | Mini-Fit Jr | 8 | pcs | Molex | 39-30-1020 | TH | connector | Digi-Key | WM3800-ND | 2.50
3 | W1-W8 | Twisted-pair coil cable, 0.5 m, 20 AWG, shielded | 0.5 m | 8 | pcs | Belden | 9501 | bulk | cable | Digi-Key | BEL1454-100-ND | 3.50
4 | GUARD | Non-metal ICNIRP guard, open-top ring at ~57 mm contour | 57 mm | 1 | pcs | custom | GUARD-57MM | mech | mech | in-house | 3D print/acrylic | 30.00
5 | FAST | Plastic fasteners/standoffs, M3 | M3 | 1 | lot | custom | M3-PLASTIC | mech | mech | in-house | stock | 10.00
 | TOTAL FG-01

Sheet: PWR-DRV-01
Company: | Concordia University, Department of Electrical and Computer Engineering
Project: | EM AccuBot - Team 25 (ELEC/COEN 490)
Design ref.: | PWR-DRV-01 - driver + DAC + power
Prepared by: | Team 25 / design review
Rev.# | 0.01 | Date: | 2026-10-27
Approved by: | (sign before order)
BOM - PWR-DRV-01 - M16 DAC80508 + LTC1563-2 + driver + power (Rev 0.02, estimates; re-quote at order)
Item # | Design Reference # | Description | Value | QTY | Unit | Manufacturer | Manufacturer Part# | Package | Type | Supplier | Supplier P/N | Price (CAD) | Ext.price (CAD)
1 | PCB | 4-layer BRD-01 PCB, 250x200 mm (zones A-C), 1.6 mm, ENIG | 250x200 mm | 5 | pcs | JLCPCB | PWR-DRV-200X150-4L | PCB | PCB-fab | JLCPCB | quote at order | 25.00
2 | U10,U10S | 16-bit 8-channel SPI DAC, 200 kSPS (build + spare) | DAC80508 | 2 | pcs | Texas Instruments | DAC80508MRTET | WQFN-16 | IC-DAC | Digi-Key | 296-DAC80508MRTETCT-ND | 42.52
3 | U30-U37 | Precision op-amp, current-loop error amp / summer / reference buffer | OPA192 | 10 | pcs | Texas Instruments | OPA192IDR | SOIC-8 | IC-opamp | Digi-Key | 296-37238-1-ND | 4.12
4 | U40-U45 | Dual precision op-amp, current-sense buffers | OPA2192 | 6 | pcs | Texas Instruments | OPA2192IDR | SOIC-8 | IC-opamp | Digi-Key | 296-OPA2192IDR-ND | 7.14
5 | U20-U27 | 300 mA high-speed buffer, constant-current output (8 + 2 spares) | LMH6321 | 10 | pcs | Texas Instruments | LMH6321MR/NOPB | SO-PowerPAD-8 | IC-buffer | Digi-Key | LMH6321MR/NOPB-ND | 7.18
6 | U50 | 4.096 V XFET voltage reference, 0.04% | ADR434 | 1 | pcs | Analog Devices | ADR434BRZ | SOIC-8 | IC-VREF | Digi-Key | ADR434BRZ-ND | 23.01
7 | U60-U67 | Rail-to-rail comparator, per-coil overcurrent | TLV3201 | 10 | pcs | Texas Instruments | TLV3201AIDBVR | SOT-23-5 | IC-comp | Digi-Key | 296-TLV3201AIDBVRCT-ND | 1.50
8 | R20-R27 | Current-sense resistor 1.00 ohm 0.1% 0.5 W | 1.00 R | 10 | pcs | Vishay | Y14531R00000B9L | axial | resistor | Digi-Key | Y14531R00000B9L-ND | 1.50
9 | C20-C27 | AC coupling capacitor 100 uF 25 V film | 100 uF | 10 | pcs | KEMET | R60PN1100AA30J | radial | capacitor | Digi-Key | 399-R60PN1100AA30J-ND | 1.50
10 | C30-C31 | Mid-rail reservoir 1000 uF 25 V | 1000 uF | 2 | pcs | Nichicon | UHE1E102MHD | radial | capacitor | Digi-Key | 493-1571-ND | 2.00
11 | U70 | 5 V 1.5 A drop-in DC-DC module | OKI-78SR-5/1.5 | 1 | pcs | Murata | OKI-78SR-5/1.5-W36H-C | SIP-3 | DC-DC | Digi-Key | 811-2692-ND | 8.07
12 | U71 | 3 A 5 V buck alternate (if FPGA board >1.2 A) | TPS54331 | 1 | pcs | Texas Instruments | TPS54331D | SOIC-8 | DC-DC | Digi-Key | 296-24372-5-ND | 2.85
13 | K2 | Force-guided relay, driver enable, 15 V coil | 15 V | 1 | pcs | Omron | G7SA-2A2B-DC24 | relay | relay | Digi-Key | Z2862-ND | 20.00
14 | PROT | Input protection: 3 A fuse, SMBJ18A TVS, common-mode choke, reverse MOSFET | 15 V | 1 | lot | various | PROT-15V | mixed | protection | Digi-Key | kit | 25.00
15 | PASS | Passives, headers, connectors, test points, 4th-order filter R/C | mixed | 1 | lot | various | PASS-DRV | mixed | passives | Digi-Key | kit | 102.00
16 | HS | Heatsink/fan for 8x LMH6321, 180 cm2 board | 8 ch | 1 | pcs | Fischer | SK-104-100-SA | heatsink | thermal | Digi-Key | SK-104-100-SA-ND | 35.00
17 | U80-U88 | 4th-order Butterworth low-pass filter, 60 kHz, one resistor per channel (8 + 1 spare) | LTC1563-2 | 9 | pcs | Analog Devices | LTC1563-2IGN#PBF | SSOP-16 | IC-filter | Digi-Key | LTC1563-2IGN#PBF-ND | 5.50
 | TOTAL PWR-DRV-01

Sheet: FE-ADC-01
Company: | Concordia University, Department of Electrical and Computer Engineering
Project: | EM AccuBot - Team 25 (ELEC/COEN 490)
Design ref.: | FE-ADC-01 - receiver + ADC
Prepared by: | Team 25 / design review
Rev.# | 0.01 | Date: | 2026-10-27
Approved by: | (sign before order)
BOM - FE-ADC-01 - receiver + ADC (Rev A, estimates; re-quote at order)
Item # | Design Reference # | Description | Value | QTY | Unit | Manufacturer | Manufacturer Part# | Package | Type | Supplier | Supplier P/N | Price (CAD) | Ext.price (CAD)
1 | PCB | PCB included in BRD-01 (zone B) | 100x100 mm | 0 | pcs | JLCPCB | FE-ADC-100X100-4L | PCB | PCB-fab | JLCPCB | quote at order | 0.00
2 | U1,U1S | 24-bit 4-ch simultaneous sigma-delta ADC (build + spare) | AD7768-4 | 2 | pcs | Analog Devices | AD7768-4BSTZ-RL7 | LQFP-64 | IC-ADC | Digi-Key | AD7768-4BSTZ-RL7-ND | 49.65
3 | U2 | 4.096 V XFET voltage reference | ADR434 | 1 | pcs | Analog Devices | ADR434BRZ | SOIC-8 | IC-VREF | Digi-Key | ADR434BRZ-ND | 23.01
4 | U3,U3S | Low-noise instrumentation amp, G=35 | INA163 | 2 | pcs | Texas Instruments | INA163UA | SOIC-14 | IC-inamp | Digi-Key | 296-14277-5-ND | 9.63
5 | U4,U4S | Fully differential ADC driver, G=2 | ADA4940-2 | 2 | pcs | Analog Devices | ADA4940-2ACPZ-R2 | LFCSP-24 | IC-fda | Digi-Key | 505-ADA4940-2ACPZ-R2CT-ND | 11.94
6 | U5-U8 | Precision op-amp, reference/VCM buffers | OPA192 | 4 | pcs | Texas Instruments | OPA192IDR | SOIC-8 | IC-opamp | Digi-Key | 296-37238-1-ND | 4.12
7 | U9 | Isolated +/-15 V 2 W DC-DC module | RV-1515D | 1 | pcs | RECOM | RV-1515D | DIP-24 | DC-DC | Digi-Key | 945-RV-1515D-ND | 20.00
8 | U10,U11 | 36 V 1 A ultralow-noise positive LDO | TPS7A4701 | 2 | pcs | Texas Instruments | TPS7A4701RGWR | VQFN-20 | IC-LDO | Digi-Key | 296-37719-1-ND | 5.03
9 | U12 | Negative ultralow-noise LDO | TPS7A33 | 1 | pcs | Texas Instruments | TPS7A3301RGWR | VQFN-20 | IC-LDO | Digi-Key | 296-30675-1-ND | 8.00
10 | U13 | 3.3 V low-noise LDO | TPS7A20 | 1 | pcs | Texas Instruments | TPS7A2033PDBVR | SOT-23-5 | IC-LDO | Digi-Key | 296-TPS7A2033PDBVRCT-ND | 1.50
11 | Y1,Y1S | 32.768 MHz CMOS oscillator, 3.3 V (build + spare) | 32.768 MHz | 2 | pcs | Citizen | CSX750FBC32.768M-UT | SMD-7050 | oscillator | Digi-Key | 300-7250-1-ND | 4.28
12 | PASS | Passives, connectors, RC network, ESD protection | mixed | 1 | lot | various | PASS-FE | mixed | passives | Digi-Key | kit | 65.00
13 | ALT-ADC | BACKUP ONLY: quad 24-bit 144 kSPS ADC | ADS1274 | 0 | pcs | Texas Instruments | ADS1274IPAPR | HTQFP-64 | IC-ADC | Digi-Key | 296-ADS1274IPAPR-ND | 0.00
 | TOTAL FE-ADC-01

Sheet: FPGA-IF-01
Company: | Concordia University, Department of Electrical and Computer Engineering
Project: | EM AccuBot - Team 25 (ELEC/COEN 490)
Design ref.: | FPGA-IF-01 - FPGA interface
Prepared by: | Team 25 / design review
Rev.# | 0.01 | Date: | 2026-10-27
Approved by: | (sign before order)
BOM - FPGA-IF-01 - FPGA interface (Rev A, estimates; re-quote at order)
Item # | Design Reference # | Description | Value | QTY | Unit | Manufacturer | Manufacturer Part# | Package | Type | Supplier | Supplier P/N | Price (CAD) | Ext.price (CAD)
1 | PCB | PCB included in BRD-01 (zone C) | 100x100 mm | 0 | pcs | JLCPCB | FPGA-IF-100X100-2L | PCB | PCB-fab | JLCPCB | quote at order | 0.00
2 | U1 | QSPI config flash, 64 Mb, SOIC-8 | W25Q64JV | 1 | pcs | Amphenol | 71918-140LF | TH | connector | Digi-Key | 609-71918-140LF-ND | 2.00
3 | U2 | USB-UART bridge, 3.3 V | FT231XQ | 1 | pcs | 3M | 3302/40-100 | ribbon | cable | Digi-Key | MB40A-5-ND | 4.00
4 | U1,U2 | Optocoupler, E-stop status / fault isolation | TLP291 | 2 | pcs | Toshiba | TLP291(GB,SE | SOIC-4 | opto | Digi-Key | TLP291GBSE-ND | 1.50
5 | PASS | Passives, connectors, 2x7 JTAG header, supervisor, test points | mixed | 1 | lot | various | PASS-IF | mixed | passives | Digi-Key | kit | 25.00
6 | FAN | 80 mm fan, 5 V, low noise | 80 mm | 1 | pcs | Noctua | NF-A8-5V | fan | thermal | Digi-Key | NF-A8-5V-ND | 12.00
7 | FPGA | FPGA XC7A35T-1FTG256C (33k LC, 1.8 Mb BRAM, 90 DSP, 170 I/O) | FTG256 | 1 | pcs | Digilent | ZYBO-Z7-20 (owned) | board | FPGA | owned | owned | 70.00
 | TOTAL FPGA-IF-01

Sheet: PEN-01
Company: | Concordia University, Department of Electrical and Computer Engineering
Project: | EM AccuBot - Team 25 (ELEC/COEN 490)
Design ref.: | PEN-01 - pen coil + cable
Prepared by: | Team 25 / design review
Rev.# | 0.01 | Date: | 2026-10-27
Approved by: | (sign before order)
BOM - PEN-01 - pen coil + cable (Rev A, estimates; re-quote at order)
Item # | Design Reference # | Description | Value | QTY | Unit | Manufacturer | Manufacturer Part# | Package | Type | Supplier | Supplier P/N | Price (CAD) | Ext.price (CAD)
1 | J1,J2 | Mini-XLR 3-pos chassis receptacle, male pins | IO-TXLR3-M | 3 | pcs | IO | IO-TXLR3-M-PS-1 | panel | connector | Digi-Key | 1937-IO-TXLR3-M-PS-1-ND | 8.41
2 | P1,P2 | Mini-XLR 3-pos cable plug, female sockets | IO-TXLR3-F | 3 | pcs | IO | IO-TXLR3-F | cable | connector | Digi-Key | 1937-IO-TXLR3-F-ND | 9.06
3 | W1a,W1b | Mogami W2697 2-conductor 28 AWG miniature balanced cable | W2697 | 10 | ft | Mogami | W2697 | bulk | cable | Studio Economik | ID 12608 | 0.75
4 | W2 | Mogami W2893 4-conductor 26 AWG mini quad cable (reference) | W2893 | 5 | ft | Mogami | W2893 | bulk | cable | Studio Economik | ID 5521 | 1.61
5 | COIL | Coil B build: 319 T, 0.19 mm wire, Delrin former, 3D shell, magnet tape | 319 T | 2 | pcs | in-house | COIL-B | pen | coil | in-house | winding | 25.00
6 | REF | Reference coil B, fixed at FG edge | 319 T | 1 | pcs | in-house | COIL-B-REF | ref | coil | in-house | winding | 25.00
7 | MISC | Epoxy, shield braid, strain relief, labels | mixed | 1 | lot | various | PEN-MISC | mixed | mech | Digi-Key | kit | 10.00
 | TOTAL PEN-01

Sheet: PMS-01
Company: | Concordia University, Department of Electrical and Computer Engineering
Project: | EM AccuBot - Team 25 (ELEC/COEN 490)
Design ref.: | PMS-01 - follower XYZ
Prepared by: | Team 25 / design review
Rev.# | 0.01 | Date: | 2026-10-27
Approved by: | (sign before order)
BOM - PMS-01 - follower XYZ (Rev A, estimates; re-quote at order)
Item # | Design Reference # | Description | Value | QTY | Unit | Manufacturer | Manufacturer Part# | Package | Type | Supplier | Supplier P/N | Price (CAD) | Ext.price (CAD)
1 | STAGE | MicroManipulatorStepper mechanical kit incl. 3 motors, encoders, ball joints, printed parts | XYZ | 1 | kit | 0x23 | MMS-KIT | kit | mech | open-source | GitHub BOM | 320.00
2 | PICO | Raspberry Pi Pico 2 (RP2350) | Pico 2 | 3 | pcs | Raspberry Pi | SC1631 | module | MCU | Digi-Key | 2648-SC1631CT-ND | 7.00
3 | DRV | Stepper driver module, TMC2209 | TMC2209 | 3 | pcs | Trinamic | TMC2209Silent | module | driver | Digi-Key | TMC2209-ND | 12.00
4 | PSU | 5 V 2 A supply for Pico/drivers | 5 V 2 A | 1 | pcs | Mean Well | GSM25E05-P1J | adapter | PSU | Digi-Key | GSM25E05-P1J-ND | 15.00
5 | MISC | Fasteners, printed parts, wiring | mixed | 1 | lot | various | PMS-MISC | mixed | mech | Digi-Key | kit | 20.00
 | TOTAL PMS-01

Sheet: ENCL-01
Company: | Concordia University, Department of Electrical and Computer Engineering
Project: | EM AccuBot - Team 25 (ELEC/COEN 490)
Design ref.: | ENCL-01 - enclosure + camera
Prepared by: | Team 25 / design review
Rev.# | 0.01 | Date: | 2026-10-27
Approved by: | (sign before order)
BOM - ENCL-01 - enclosure + camera (Rev A, estimates; re-quote at order)
Item # | Design Reference # | Description | Value | QTY | Unit | Manufacturer | Manufacturer Part# | Package | Type | Supplier | Supplier P/N | Price (CAD) | Ext.price (CAD)
1 | ENC | Aluminum enclosure 400x300x150 mm, instrument case | 400x300x150 | 1 | pcs | Hammond | 1458VD5B | case | mech | Digi-Key | HM-1458VD5B-ND | 120.00
2 | SHIELD | Internal aluminum/copper-clad shield partition | custom | 1 | pcs | in-house | SHIELD-01 | mech | mech | in-house | sheet | 25.00
3 | ESTOP | NC mushroom E-stop, 22 mm, latching, IP65 | XB4BS8444 | 1 | pcs | Schneider | XB4BS8444 | panel | safety | Digi-Key | XB4BS8444-ND | 30.00
4 | FAN | Fan/filter kit for enclosure | 80 mm | 1 | pcs | various | FAN-FILTER-80 | kit | thermal | Digi-Key | kit | 25.00
5 | CABLES | Panel cables, feedthroughs, strain relief | mixed | 1 | lot | various | CABLE-ENCL | mixed | cable | Digi-Key | kit | 50.00
6 | CAM | USB digital microscope, 50x-500x, LED | 50x | 1 | pcs | AmScope | AM-50X-500X | camera | camera | Amazon | B07N8J2R9F | 75.00
7 | MON | 7 inch HDMI monitor, 1024x600 | 7 in | 1 | pcs | various | 7IN-HDMI | monitor | display | Amazon | quote | 60.00
8 | PANEL | Panel connectors: 15 V inlet, USB, HDMI, E-stop | mixed | 1 | lot | various | PANEL-01 | mixed | connector | Digi-Key | kit | 30.00
 | TOTAL ENCL-01

Sheet: Sourcing_notes
SOURCING NOTES - SYSTEM-01
Topic | Note
Purpose | Trace every BOM row to a locked decision, a price source, and a lifecycle note. Re-quote before order.
DAC80508 / LTC1563-2 | M16 selected 2026-10-27. DAC80508MRTET (WQFN-16, M=midscale reset, SDO pin, 250 small T&R): Digi-Key 296-DAC80508MRTETCT-ND, $29.84 USD (~$42.52 CAD) 1+, 312 in stock. Mouser DAC80508ZCYZFT/DSBGA €22.81 (~$36.6 CAD) is Z (zero-scale) + C (CLR) + DSBGA, NOT equivalent to MRTET; do not substitute without a footprint/function change. LCSC C2679540 $22.70 USD (~$32.4 CAD) 27-49 in stock. AliExpress/Taobao ~98 CNY (~$19.6 CAD) but counterfeit risk; not for the accuracy build. LTC1563-2IGN#PBF: $3.13 at 1ku, ~$5.50 single.
LMH6321 | TI product page ACTIVE (300 mA buffer, 8-SO PowerPAD); distributor stock thin. Buy 8 + 2 spares now. Fallback: vendor Rev A discrete stage or a comparable high-current buffer with a deviation.
AD7768-4 | Digi-Key AD7768-4BSTZ-RL7, 64-LQFP; 2 pcs (build + spare). ADS1274IPAPR is a QTY=0 backup only.
INA163 | SOIC-14, 1.1 nV/sqrtHz; 2 pcs (build + spare). AD620/AD627 is 100 mm fallback only.
ADA4940-2 | LFCSP-24, fully differential ADC driver; 2 pcs (build + spare). ADA4896-2 is the alternate.
ADR434 | 4.096 V XFET reference; one per board (driver + FE). Buffer with OPA192.
ME60A1503F01 | SL Power / Advanced Energy 15 V, 60 W, medical-grade, IEC C14 desktop; ~$36-51 USD. Confirm stock and cord.
RV-1515D | RECOM 15 V in, +/-15 V out, 2 W, +/-66 mA; isolated analog module. LDO to +/-12 V with TPS7A4701/TPS7A33.
CSX750FBC32.768M | Citizen 32.768 MHz CMOS XO, 3.3 V, ~$3.00 USD; one per FE board + spare. Jitter is adequate for the 30 ps target; measure at ADC-5.
E-stop | Schneider XB4BS8444 (2NC, 22 mm) or AutomationDirect GCX1131 (1NC, 22 mm). NC contact in the +15 V_DRV enable; opto status to FPGA.
Enclosure | Hammond 1458VD5B class 400x300x150 mm; internal shield partition; fan/filter. No metal within 150 mm of the tracking volume.
PMS | MicroManipulatorStepper open-source kit; price is an estimate. Confirm the StepWiseDocs BOM; the repo BOM has deprecated parts.
Camera | USB microscope 50x-500x (AmScope class) + 7 inch HDMI monitor; Phase 1 budget had 75 CAD for camera/test.
FX | 1 USD = 1.425 CAD; 1 EUR = 1.604 CAD (Oct 2026, phase2/README.md).
Budget | M16 baseline is ~$2214 full system / ~$1387 controller-only; still above the $1000 cap. See Budget sheet for the variance and options. Do not order until the team signs the deviation or the trimmed configuration.
Do-not-do | Do not add FG/PMS/enclosure rows to the sub-assembly sheets; they belong on their own sheets. Do not edit vendor/ or docs/BOM_template.xls.
FG PCB (300x300) | The $95 CAD in FG-01 is a placeholder, not a quote. A 300x300 mm 2-layer 1.6 mm 1 oz ENIG board is priced by lot: 5 pcs typically ~$80-150 USD (~$115-215 CAD) plus shipping, i.e. ~$23-43 CAD/board; 2 pcs ~$50-100 USD (~$70-145 CAD) plus shipping, ~$35-72 CAD/board. Re-quote with the Gerbers; order 5 pcs for spares if the lot price is better. The 25-turn 0.5/0.25 mm traces are standard and add no fabrication premium.
Prototype DAC (bench) | Pmod DA4 (Digilent, AD5628-1, 12-bit octal, 0-2.5 V, 32-bit SPI frames) is an allowed functional stand-in before the M16 board exists, but it is a DIFFERENT protocol: 32-bit frames, 8 frames/update, command 0010 update-all, no TRIGGER register. Run at XO/180 = 182.04 kSPS (256 bits at 49.152 MHz = 5.208 us does not fit the 5.005 us M16 period). code12 = code16/8 (2.5 V full scale, not >>4). AD5628 setup/hold are 4/4 ns, so it does NOT validate the DAC80508 0.17 ns hold. Quantization spurs ~-50 dBc; do not calibrate kappa on it.
16-bit bench DAC (option) | TI DAC80508-04EVM (formerly DAC80508EVM), Digi-Key 296-DAC80508-04EVM-ND, ~$59 USD (~$81 CAD) list; 12-week lead, check local stock. Carries the DAC80508 in the 3x3 mm QFN, on-board 5 V/3.3 V rails, 8 output header pins, external SPI header, trigger output, on-board FT4232 (no USB2ANY needed). Good for 16-bit functional/INL/update-all checks; NOT a 49 MHz timing vehicle (FT4232 + header jumpers) and not a coil driver. A 2-layer DAC+filter slice board is cheaper and tests the real 49 MHz path. Verify the installed variant marking; the GUI default gain may be 1 (0-2.5 V) - force gain 2.
BRD-01 single board | One 4-layer electronics board replaces PWR-DRV-01 + FE-ADC-01 + FPGA-IF-01. The three PCB lines were merged into the PWR-DRV sheet (5 x $25 = $125 placeholder, total unchanged); re-quote the 250x200 4-layer Gerbers. FPGA integration (on-board Zynq, module, or owned dev board) is still open and is not in this total.
