poisnoir/Capstone/hardware/bom/BOM_template.xls

Company: | Concordia University, Department of Electrical and Computer Engineering
Project: | _Your project name and team number_
Design ref.: | _Your system/module/sub-module part or reference number_
Prepared by: | _Your name_
Rev.# | 0.00 | Date: | September 1, 2050
Approved by:
Item # | Design Refererence # | Description | Value | QTY | Unit | Manufacturer | Manufacturer Part# | Package | Type | Supplier | Supplier P/N | Price | Ext.price
1 | C1,C2,C9,C10,C12,C13, C15,C16,C21,C23-C25 | 0.1µF ±10% 16V Ceramic Capacitor X7R 0805 (2012 Metric) | 0.1uF | 12 | pcs | KEMET | C0805C104K4RACTU | 0805 | SMD | DigiKey | 399-1167-6-ND | 0.1300 | 1.5600
2 | D1-D3 | Yellow 588nm LED Indication - Discrete 1.85V Radial | WP710A10LYD | 3 | pcs | Kingbright | WP710A10LYD | 3mm | DNS | DigiKey | 754-1592-ND | 0.1800 | 0.5400
3 | IC1 | AVR Automotive, AEC-Q100, AVR ATmega Microcontroller IC 8-Bit 16MHz 32KB (16K x 16) FLASH 32-TQFP (7x7) | ATMEGA328P | 1 | pcs | Microchip Technology | ATMEGA328P-15AZ | 32TQFP | SMD | DigiKey | ATMEGA328P-15AZDKR-ND | 8.4900 | 8.4900
4 | P1 | Connector Header Through Hole 6 position 0.100" (2.54mm) | M20-9980346 | 1 | pcs | Harwin Inc. | M20-9980346 | DIL | thru-hole | DigiKey | 952-2121-ND | 0.2800 | 0.2800
5 | Q1 | P-Channel 20V 3.7A (Ta) 1.3W (Ta) Surface Mount Micro3™/SOT-23 | IRLML6402 | 1 | pcs | Infineon Technologies | IRLML6402TRPBF | SOT-23 | SMD | DigiKey | IRLML6402PBFDKR-ND | 0.4700 | 0.4700
6 | R3-R7,R15 | 510 Ohms ±5% 0.125W, 1/8W Chip Resistor 0805 (2012 Metric) Moisture Resistant Thick Film | 510 Ohms | 6 | pcs | Yageo | RC0805JR-07510RL | 0805 | SMD | DigiKey | 311-510ARDKR-ND | 0.1300 | 0.7800
7 | U1 | Voltage Level Translator Bidirectional 1 Circuit 4 Channel 100Mbps 14-SOIC | TXB0104 | 1 | pcs | Texas Instruments | TXB0104DR | 14-SOIC | SMD | DigiKey | 296-21928-6-ND | 2.0400 | 2.0400
8 | X1 | 16MHz ±50ppm Crystal 20pF 80 Ohms 4-SMD, No Lead | 16MHz | 1 | pcs | ECS Inc. | ECS-160-20-33-TR | 4-SMD | SMD | DigiKey | XC1137DKR-ND | 1.8600 | 1.8600
9
10
11
12
13
14
15
16
17
18
19
20
21
22
23
24
25
26
27
28
29
30
31
32
33
34
35
36
37
38
39
40
 |  |  |  |  |  |  |  |  |  |  |  | Total: | 16.0200
 |  |  | This is optional information. You don't have to include it.
 |  | Board summary
 |  | Total # of components to install |  | 23 |  | Total BOM items to install |  |  | 7
 |  |  | SMD | 22 |  |  |  | SMD | 6
 |  |  | thru-hole | 1 |  |  |  | Throu-hole | 1
