poisnoir/Capstone/hardware/bom/connector_requirements.xlsx

Sheet: Locked-CONN
Phase 2 — LOCKED connector decision (sensor coil → preamp, analog) [Rev B: IO primary, AG alt]
Source: phase2/README.md §§2-6 (specs #1-25), AGENTS.md full-FPGA override, Jaeger 2018 Ch.7, fSysSetup/fSysGetField/fDAQSetup. Frozen refs — numbers traceable, none invented.
Line | Part | Role / gender | Qty | Mount / mate | Spec check | Phase-2 spec trace
L1 | IO IO-TXLR3-M-PS-1 (DigiKey 22517901 — LOCKED) | Chassis receptacle, MALE pins, solder cup | 2 | Panel bulkhead rear; on preamp box; IEC 61076-2-103 | 3-pos mini-XLR; brass/gold; ≤10mΩ, >1GΩ, 1000V/60s, >1000 cycles; mates IO-TXLR3-F | #1-2 (2 pens max), #19 pen cable OK (linkage-free), #21-25 lab/budget
L2 | IO IO-TXLR3-F (Jameco/Newark — LOCKED) | Cable plug, FEMALE sockets, solder | 2 | Cable ~2-3.5mm OD; mates IO-TXLR3-M-PS-1 1:1; same brand per pair | 3-pos mini-XLR; bronze/gold; ≤10mΩ, 5A/50V; shielded pair + drain | #1-2 (probe + ref/spare), #5-6 κ-stable (ΔR<10mΩ), #19 ≤50g
L3 | Pairing (alt: Amphenol AG3MCC + AG3F approved second-source) | 2 mating pairs = 2 sensor channels | 2 pairs | Pen→preamp analog µV; current-sense stays BNC, NOT here | Female cable → male panel (mic convention, no exposed pins on pen) | #14-16 latency/rate unaffected (passive)

Sheet: Locked-CAB
Phase 2 — LOCKED cable decision (sensor coil → preamp whip) [Rev D: 34 kHz tone plan, 73 pF total]
Source: phase2/README.md §§2-6; RQ-CAB thresholds; Economik per-feet SKUs ID 12608 (W2697) / ID 5521 (W2893), Montreal walk-in, qty=feet.
Line | Part | Role | Qty | Fit / mate | Spec check | Trace
C1 | Mogami W2697 2c 28AWG miniature balanced (LOCKED pen whip) | Pen whip: 1pr twisted + served shield; 2.5mm OD | 10 ft cut (2x 0.6m whips + spare) | Studio Economik ID 12608, $0.75 CAD/ft | ~65pF/m → 0.6m=39+20=59pF ≤73pF at 34kHz top tone; fits IO 2-3.5mm chuck; lavalier flex | #1-2,#5-6,#12-13,#19
C2 | Mogami W2893 4c 26AWG mini quad (approved: static ref only) | Reference run: 4c paralleled to pair + shield; ~4mm OD | 5 ft cut | Studio Economik ID 5521, $1.61 CAD/ft | Quad +10-20dB; ~130pF/m → cap 0.5m air-coils; jacket-strip chuck trick | #1-2 (ref),#5-6
C3 | Termination (AES48) | Pen plug Pin1 = braid only, coil→shield ∞Ω; panel Pin1+shell → chassis star | 2 whips | IO-TXLR3-F / M-PS-1 Rev B | DMM verify ∞Ω coil-shield; pigtail <10mm | #5-6,#20

Sheet: RQ-CONN
Phase 2 — connector requirements (any vendor must pass)
Source: phase2/README.md §§2-6 (specs #1-25), AGENTS.md full-FPGA override, Jaeger 2018 Ch.7, fSysSetup/fSysGetField/fDAQSetup. Frozen refs — numbers traceable, none invented.
Req ID | Requirement (threshold) | Math / rationale | Verify | Trace (#)
RQ-C1 | 3 poles min: SIG+ / SIG- + shield drain; 5-pole only for co-located 6-DOF | 2 wires/coil; shared-shield Xtalk Vx=I·Rsh | Pinout continuity + hi-pot | #1-2
RQ-C2 | R_contact ≤30mΩ init, ΔR ≤10mΩ/life; R_iso ≥1GΩ | Rc/Rcoil<0.04 (0.03/0.8); en=√(4kTRB); Ileak=Vs/Riso (1nA) | 4-wire mΩ before/after 1000 mates; IR @125V | #5-6 (κ resid 1e-15)
RQ-C3 | C_contact ≤10pF; C_total≤73pF (conn+cable+amp) at 34kHz top tone | fres=1/2π√(LC)>10×34kHz; worst E+ferrite 3mH→Cmax≈73pF; Xc=1/2πfC≈64kΩ at 34kHz/73pF | LCR @25kHz; fres sweep 20-500kHz | #5-6 phase-sign
RQ-C4 | >1000 mates, latch, ≤20N, chuck 2-4mm, shell <10g off-pen | 49-98 inserts/cal × recals; torque=m·g·d vs 50g/6-12Hz | Cycle rig + scale + pull gauge | #19, #12-13
RQ-C5 | 360° shield, single-point star at ADC; shell >30-50mm from coil | No loop via FG/driver; zinc mass Eddy inside 150mm metal-free zone | Shield Ω + field-probe A/B | #20 (≤27µT), default cond.
RQ-C6 | Pmod/SPI is DIGITAL ADC→Zynq, not preamp; host=Female, peripheral=Male | Digilent Pmod spec 2×6 100mil; SCLK/MOSI/MISO/CS+CONVST/DRDY | Visual + loopback | #14-16

Sheet: ALT-matrix
Phase 2 — component alternatives, weighted (OIQ 3.1.2 style; weights sum 1.0) [Rev B]
Source: phase2/README.md §§2-6 (specs #1-25), AGENTS.md full-FPGA override, Jaeger 2018 Ch.7, fSysSetup/fSysGetField/fDAQSetup. Frozen refs — numbers traceable, none invented.
Criterion (weight) | Wt | IO-TXLR3-M-PS-1 + IO-TXLR3-F (LOCKED) | Amphenol AG3MCC + AG3F (approved alt) | Switchcraft TB3 | LEMO 00B / JST-GH (final pen)
Cost/pair (0.20) | 0.20 | 5 — ~$3-4 ea (~$14/2ch) | 4 — ~$9-13 ea (~$40/2ch) | 3 — ~$12+ (~$36) | 2 — LEMO $25+; JST $1
Mating cycles (0.20) | 0.20 | 4 — gold/brass, >1000 rated, IEC | 4 — machined brass/gold | 4 — machined | 5 — LEMO 5000+; JST 30 (service burden)
Mass/OD pen side (0.20) | 0.20 | 4 — ~10g, 3.5mm max | 4 — ~10g, 2-4mm | 3 — heavier shell | 5 — 3-5g / 1.5g JST
Solder/build speed (0.15) | 0.15 | 4 — cup, 24AWG, fine iron | 3 — tiny cups, loupe | 4 — large cups | 2 — LEMO fiddly; JST crimp tool
Shield/chuck fit (0.15) | 0.15 | 4 — 360°, 2-3.5mm | 5 — 360°, 2-4mm | 4 — 360° | 3 — micro shield harder
Stock CAD (0.10) | 0.10 | 5 — DigiKey/Mouser/TME in-stock | 5 — in-stock | 3 — longer lead | 4 — JST stock; LEMO order
Weighted total (/5) | 1.00 | 4.45 | 4.15 | 3.45 | 3.30 (pen-final only)

Sheet: RQ-CAB
Phase 2 — cable requirements (any bulk wire must pass)
Source: phase2/README.md §§2-6 (specs #1-25), Jaeger Ch.7 Eq.7.2/7.9 (vs∝N·Ac·µa), Ch.3 Eq.3.17-3.27, fSysSetup/fSysGetField. Worst-case L=E+ferrite ~3mH; built coils B-air 804µH / C-air 91µH / C-ferr ~273µH.
Req ID | Requirement (threshold) | Math / rationale | Verify | Trace (#)
RQ-B1 | 2c + braid/spiral shield; 24-28AWG stranded OFC; Rcond ≤0.2Ω/m, Rsh ≤0.1Ω/m | Rcab/Rcoil<0.25 (0.16/0.8 worst C); en=√(4kTRB) cab adds <20% coil noise | DMM Ω/m; noise floor A/B | #5-6
RQ-B2 | K0 (cond-shield) ≤150pF/m AND L×K0 ≤56pF budget at 34kHz; K1 (cond-cond) ≤15pF/m; length ≤0.8m | Ctot=L·K0+Cconn7pF+Camp10pF; fres=1/2π√(LC)>10×34kHz. Worst 3mH→73pF max; built B 804µH→272pF max, C-air 91µH→nF — MS202 0.8m≈59-116pF passes built, fails worst (documented) | LCR K0/K1 @1/25kHz; fres sweep | #5-6 phase-sign
RQ-B3 | Shield ≥90% braid/served (pen flex); spiral OK, foil REJECT on whip; 360° term, pigtail <10mm | Transfer Z ∝(1-coverage); foil cracks @6-12Hz tremor → coverage loss + tribo | Coverage datasheet + flex 10k + shield-Ω | #12-13, #5-6
RQ-B4 | OD 2.0-3.5mm; mass ≤15g/m; flex ≥10k cycles, bend ≤30mm; handling ≤0.2mV; XLPE+conductive layer | Torque=m·g·d vs 50g pen; ΔC/C motion → ΔV=Vs·ΔC/C in 6-12Hz band | Scale + bend rig + tap test on scope/FFT | #19, #12-13
RQ-B5 | Twist pitch ≤25mm; route pen whip away from FG drive + BNC >10cm; single-point star at ADC | Loop/twist≈pitch×spacing (20mm²) vs untwisted 800mm² → ~32dB pickup cut; Vpick=2πfMI; Vsh=I·Rsh (separate shields → nV, shared → mV) | Twist measure + near-field probe A/B | #14-16, #20

Sheet: ALT-CAB
Phase 2 — cable alternatives, weighted (OIQ 3.1.2 style) [Rev D: 34 kHz tone plan]
Source: phase2/README.md §§2-6 (specs #1-25), Jaeger Ch.7 Eq.7.2/7.9 (vs∝N·Ac·µa), Ch.3 Eq.3.17-3.27, fSysSetup/fSysGetField. Worst-case L=E+ferrite ~3mH; built coils B-air 804µH / C-air 91µH / C-ferr ~273µH.
Criterion (weight) | Wt | W2697 2.5mm (LOCKED pen whip) | Mogami W2791/W2549 5.5-6mm | Canare L-2E5 4.6mm / L-2T2S 6mm | W2893 mini quad (approved static-ref)
C-budget on BUILT coils (0.25) | 0.25 | 5 — 0.6m≈59pF, passes built AND worst 3mH | 4 — K0 76-86pF/m; 0.8m≈61-69pF +17pF >73pF worst-case; built coils only | 4 — 63-70pF/m K0, passes built | 3 — ~130pF/m; 0.5m passes air, fails worst
Chuck fit 2-3.5mm (0.25) | 0.25 | 5 — 2.5mm direct fit IO chuck | 1 — 5.5-6mm fails chuck (strip/re-terminate) | 2 — 4.6-6mm fails/ream | 2 — ~4mm, jacket-strip trick
Flex/tremor (0.20) | 0.20 | 5 — lavalier flex, lowest torque | 3 — braid durable but stiff/heavy whip | 3 — stiff, heavy | 2 — 6.5x stiffer, static only
Mass/pen 50g (0.15) | 0.15 | 5 — ~8g/0.6m | 2 — ~35g/0.8m | 2 — ~25-35g | 3 — ~20g/0.6m
Handling noise (0.10) | 0.10 | 4 — served, tap-test to confirm | 5 — Neglex + conductive layer 0.15mV max | 4 — braid quiet | 4 — quad quiet
Stock/build (0.05) | 0.05 | 5 — Economik by-foot CAD walk-in ID 12608 | 4 — Mogami bulk stocked | 4 — stocked | 5 — Economik by-foot ID 5521
Weighted total (/5) | 1.00 | 4.90 | 2.85 | 2.90 | 2.95 (static-run only)
