poisnoir/Capstone/docs/setup/README.md

# Setup

- `git-workflow.md` — clone, branch, PR, two machines.
- `github-setup.md` — repo settings, org teams, Project, labels, gate issues.

The team's internal desktop/Tailscale notes are kept locally and are not in the
repo.
