poisnoir/Capstone/simulations/m16/dac_xt_0.000424.cir

* DAC crosstalk + INL sensitivity: victim 24 kHz off, 7 crosstalk tones
.param Ac=0.000424
.param LSB=5/65536
B1 d 0 V=2.5 + Ac*(sin(2*pi*20k*time)+sin(2*pi*22k*time)+sin(2*pi*26k*time)+sin(2*pi*28k*time)+sin(2*pi*30k*time)+sin(2*pi*32k*time)+sin(2*pi*34k*time))
B2 q 0 V=int(V(d)/5*65536)/65536*5
B3 e 0 V=1.0*LSB*sin(2*pi*V(q)/5*1)
B4 out 0 V=V(q)+V(e)
.tran 0 10m 0 100n
.end
