poisnoir/Capstone/simulations/m16/summer_8tone_eval.cir

* M16 summer: all 8 tones, a3 = -110 dB single-tone THD at 0.424 V
.param A=0.424
.param A3=7.03e-5
B1 s 0 V=A*(sin(2*pi*20k*time)+sin(2*pi*22k*time)+sin(2*pi*24k*time)+sin(2*pi*26k*time)+sin(2*pi*28k*time)+sin(2*pi*30k*time)+sin(2*pi*32k*time)+sin(2*pi*34k*time))
B2 out 0 V=V(s)+A3*V(s)*V(s)*V(s)
.tran 0 10m 0 100n
.end
