poisnoir/Capstone/(commit log)

2026-10-30 Initial import: EM AccuBot Phase 2 monorepo
    Team-first layout: contract/, fpga/, hardware/, robot-arm/ stub,
    software/, simulations/, docs/. Contract v1.0.0 with SC-01..SC-10,
    decisions #1-#26, pico-link ICD and manipulator requirements.
    Adds reference manifest + checkers, contract release/guard workflows,
    issue/PR templates and the arm-repo handshake kit.
    [BOM_ADC-01.xlsx, BOM_PEN-ANA-01.xlsx, BOM_SYSTEM-01.xlsx, BOM_template.xls, connector_requirements.xlsx]
2026-10-30 Make contract tree hash deterministic
    Sort by relative path string, not Path object, so a directory and a
    same-named file (pico_link/ vs pico_link.md) hash in the same order in
    the working tree and in a git revision. The tag and current hashes now
    match, so an unchanged contract does not fail the release check.
